Fleafa/VoronUsers/printer_mods/MCMBen/Voron0_Block_and_Tackle_Z_Belt/README.md

# Overview
A block & tackle Z belt implementation for the Voron 0 / 0.1 / 0.2.

The goal was to make use of the original V0 Z motor and timing belt in a compact format, using hardware and screws already in the BoM where possible. No additional M3 nuts need to be preloaded - so no disassembly of the frame.

By default this mod uses 40T & 16T pulleys, combining with the 2:1 of the block and tackle, to give a 5:1 ratio.

Larger pulleys - up to 64 teeth - can be used to increase this ratio, but will require longer timing belts.

## Version 2
I've made some changes in the ~2 years since I first designed this. The affected parts are:
* bed_rear_v3 - reworked to be stronger and print better. Added a heatset insert as I found the plastic self-tapped hole wore out.
* top_bracket_v4 - 'wings' added to add strength and prevent it slipping down under belt tension. Two 6mm screws aid alignment with the vertical extrusions, and two screws utilise the tapped ends of these extrusions to further prevent movement. The clamp (top_bracket_clamp_v1) is now printed separately, for a cleaner look.
* z_tensioner_v2 - minor changes to facilitate the above.
* bottom_bracket_v4 - reworked so that the motor doesn't prevent full belt replacement. The belt is secured from above, making assembly easier. The clamp (bottom_bracket_clamp_v1)  is now printed separately.
The Kirigami bed is now supported. I've based my parts on [LDO's version](https://github.com/MotorDynamicsLab/LDOVoron0/tree/main/STLs/Kirigami), adding an asymmetric stealth bed front design to complement [Christoph Mueller's nut block design](https://github.com/christophmuellerorg/voron_0_kirigami_bed) and a second WAGO mount complementing LDO's breakout mount.

## V0
The standard skirt/feet are too short to accomodate the motor. As such, this mod requires a taller skirt, such as:
* [hartk1213's extrusion skirt mod](https://github.com/VoronDesign/VoronUsers/tree/master/printer_mods/hartk1213/Voron0_ExtrusionSkirt)
* [doubletrouble023's skirt mod](https://github.com/VoronDesign/VoronUsers/tree/master/printer_mods/doubletrouble/V0_Skirt_Mod)
* [my own Trident-style skirt mod](https://github.com/Fleafa/VoronUsers/tree/V0.1-Trident-skirt/printer_mods/MCMBen/Voron0_Block_and_Tackle_Z_Belt)
* [the official V0.2 skirt, based on my design above, but developed further. Nicer to work with!](https://github.com/VoronDesign/Voron-0)

## V0.1
The standard skirt/feet have enough height, though a 64T pulley may be a squeeze.

## V0.2
I haven't removed the Z-stop switch part of the design, so can go sensorless or keep a switch.
The standard Trident-style skirt provides enough space.

*Full Z-travel should be possible, but be sure to check this.*

Both the V0 and V0.1/V0.2 bed positions are supported - just print the appropriate bed_front_\*.stl file.

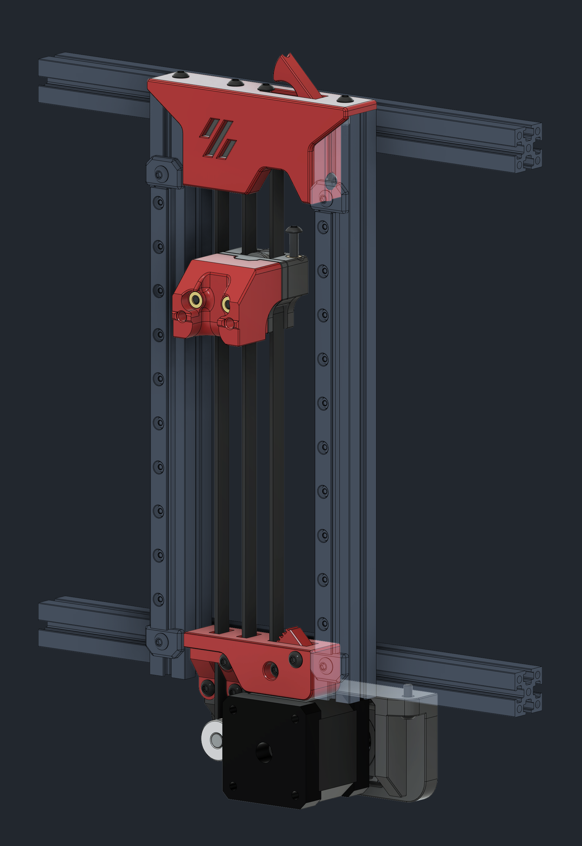
[picture p1: printer_mods/MCMBen/Voron0_Block_and_Tackle_Z_Belt/Images/Block_and_Tackle_Z_Belt_Render_v2.png]

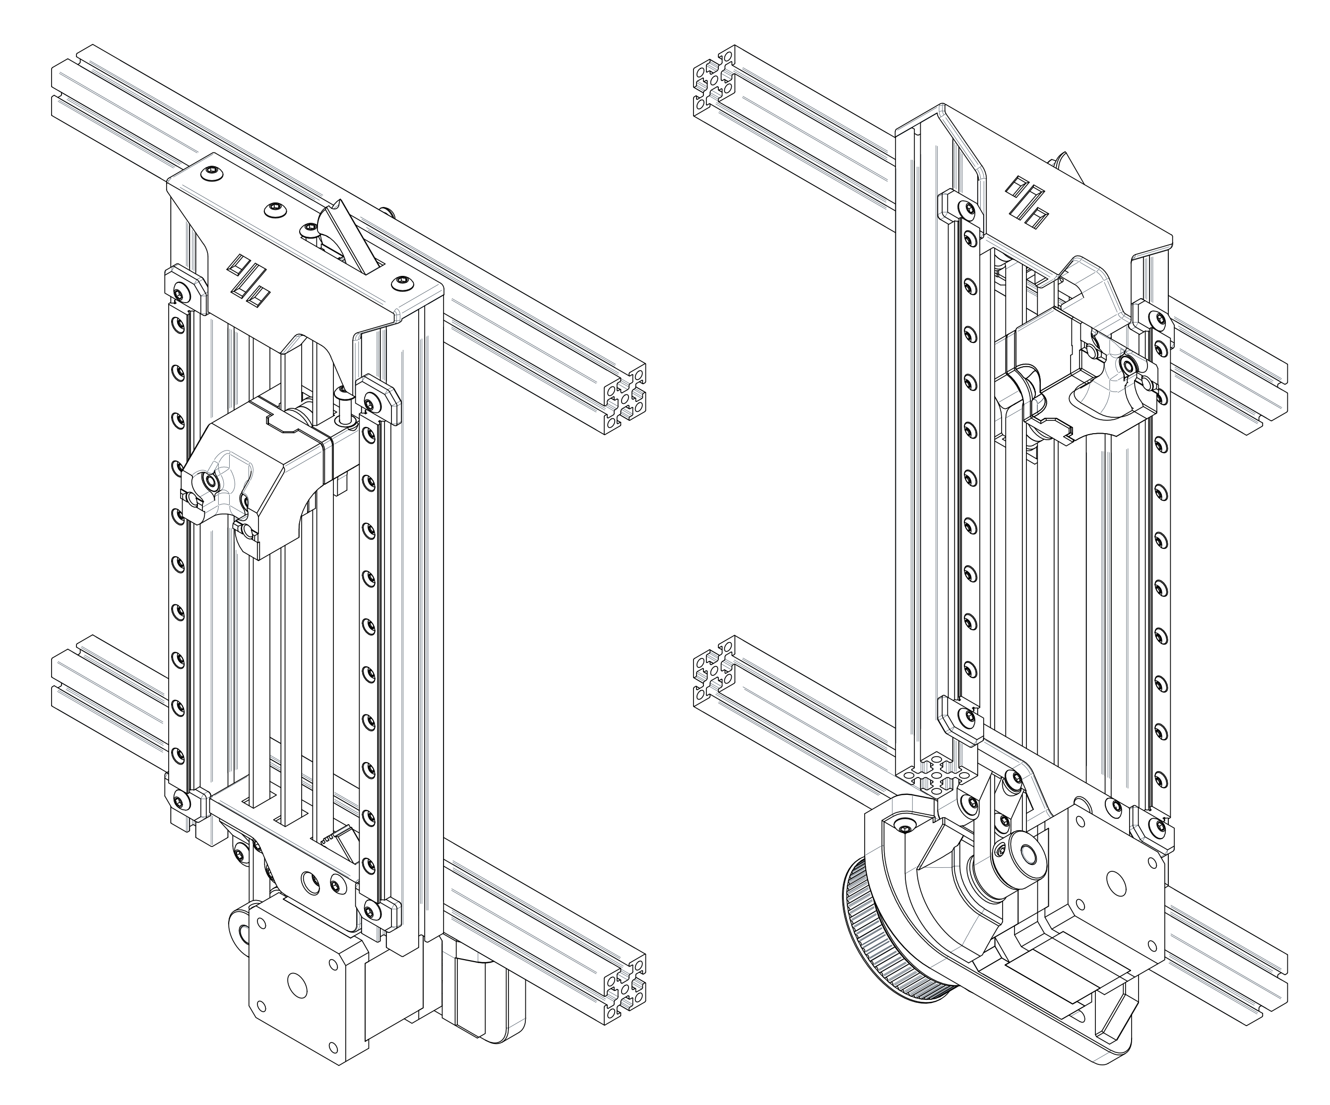
[picture p2: printer_mods/MCMBen/Voron0_Block_and_Tackle_Z_Belt/Images/Block_and_Tackle_Z_Belt_Drawing_v2.png]

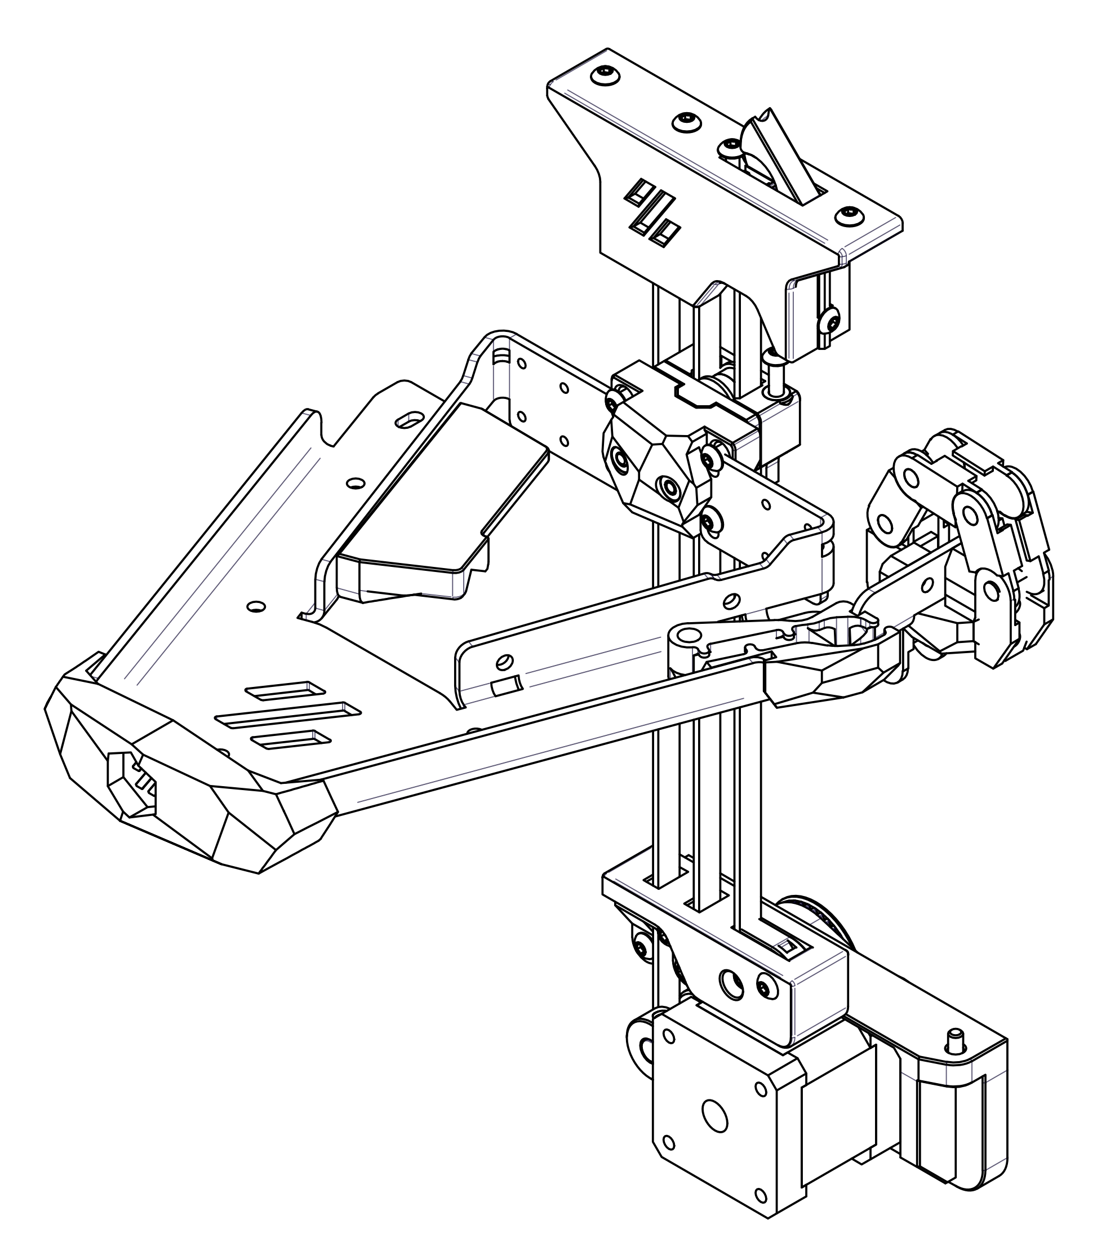
[picture p3: printer_mods/MCMBen/Voron0_Block_and_Tackle_Z_Belt/Images/Block_and_Tackle_Z_Belt_Kirigami.png]


# BoM
This BoM doesn't include Omron switch for the Z stop, though much of the hardware is reused from the V0/V0.1/V0.2 builds.
## Common
Component | Quantity
--- | :-:
M3x6 BHCS | 2
M3x8 BHCS | 1
M3x10 BHCS | 4
M3x12 BHCS | 3
M3x16 BHCS | 4
M3x25 BHCS | 3
M3x30 BHCS | 2
M3 threaded insert | 8
3x12 pin | 3
3x14 pin | 2
F623 bearing | 6
F695 2RS bearing | 1
MF105 bearing | 2
GT2 16T pulley | 3
NEMA14 motor | 1
3x6x0.5 shim | 0
5x10x0.5 shim | 2
5x50 shaft | 1
GATES GT2 open belt | ~700mm
M3 washer | 4
M2x10 self-tapping screw | 2

## Timing Belt
Ratio | Type | Length
--- | :-: | ---
5:1 | GATES GT2 | 110mm
6:1 | GATES GT2 | 122mm
8:1 | GATES GT2 | 152mm
&nbsp; | **OR** | &nbsp;
8:1 | GT2 | 146mm

#Klipper Config
This assumes SKR Mini E3 v2 and stock V0 Z motor.
```
[stepper_z]
step_pin: PB0
dir_pin: !PC5           # Remove ! if moving opposite direction
enable_pin: !PB1
rotation_distance: 32
gear_ratio: 40:16, 2:1
full_steps_per_rotation: 200
microsteps: 16
endstop_pin: PC2
position_endstop: -0.10
position_max: 120       # Check that there is enough travel
position_min: -1.5
homing_speed: 20        # Default 20, Max 100
second_homing_speed: 3.0
homing_retract_dist: 3.0

[tmc2209 stepper_z]
uart_pin: PC11
tx_pin: PC10
uart_address: 1
interpolate: True
run_current: 0.37       # For V0 spec NEMA17 LDO-35STH42-0504AH
hold_current: 0.35
sense_resistor: 0.110
stealthchop_threshold: 500

[printer]
max_z_velocity: 30      # Default 15, test before increasing
max_z_accel: 350        # Default 45, test before increasing
```
