Fleafa/VoronUsers/printer_mods/MCMBen/Voron0_Block_and_Tackle_Z_Belt/STLs/bed_front_kirigami_v1.stl

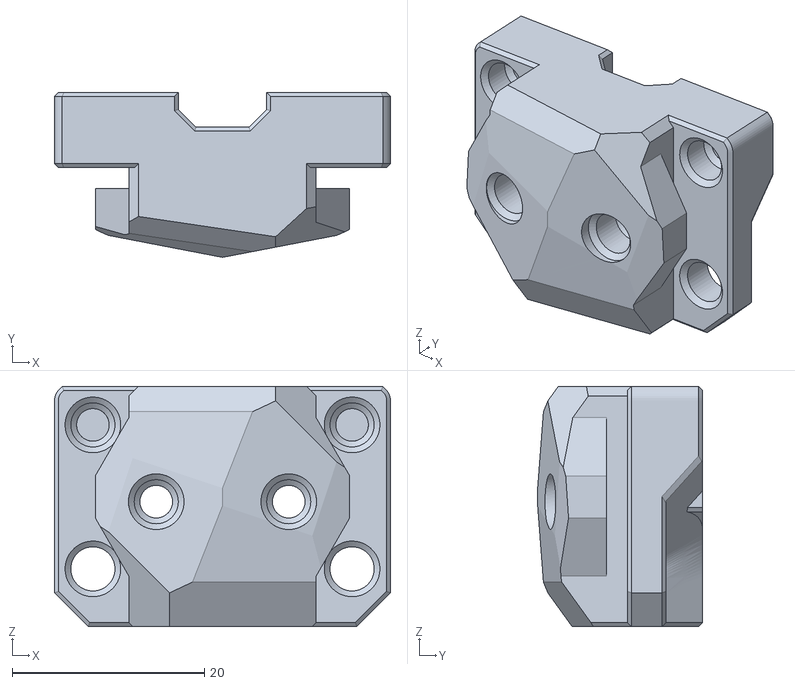
[picture p4: CAD file, 2023-05-16]
printer_mods/MCMBen/Voron0_Block_and_Tackle_Z_Belt/STLs/bed_front_kirigami_v1.stl
35.0 x 17.2 x 25.0
