Fleafa/VoronUsers/printer_mods/MCMBen/Voron0_Trident_Skirt/CAD/V0.1_Trident_Skirt_NoDisplay.step

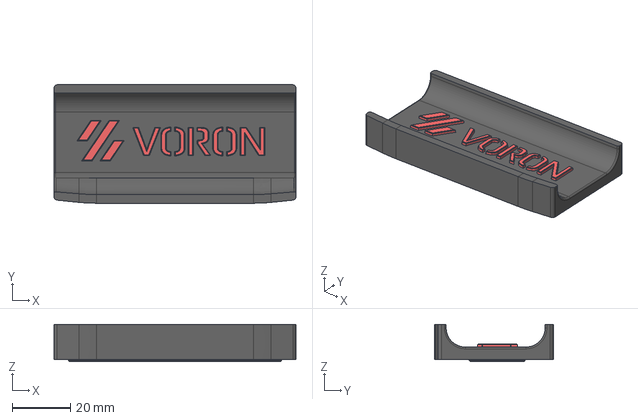
[picture p5: CAD file, 2021-11-09]
printer_mods/MCMBen/Voron0_Trident_Skirt/CAD/V0.1_Trident_Skirt_NoDisplay.step
83.2 x 40.7 x 12.8 mm
skirt_front_through_logo
[a]_skirt_front_through_logo_insert
