Fleafa/VoronUsers/printer_mods/MCMBen/Voron0_Trident_Skirt/STLs/[a]_skirt_front_through_logo_insert.stl

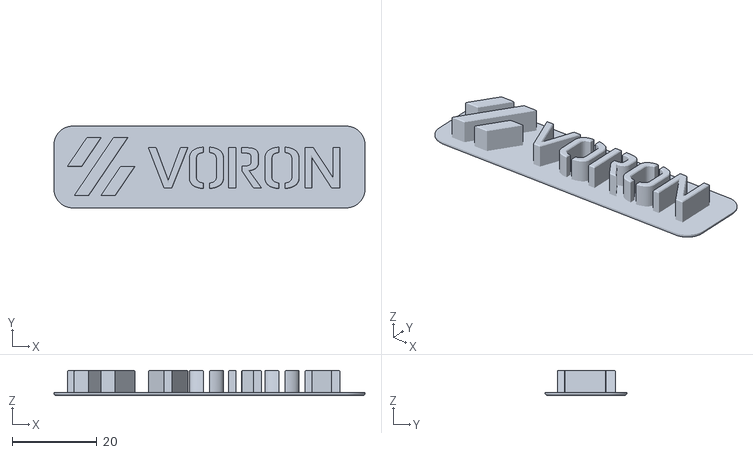
[picture p6: CAD file, 2021-10-23]
printer_mods/MCMBen/Voron0_Trident_Skirt/STLs/[a]_skirt_front_through_logo_insert.stl
73.3 x 19.3 x 6.00
