Fleafa/VoronUsers/printer_mods/MCMBen/Voron0_Block_and_Tackle_Z_Belt/STLs/kirigami-wago.stl

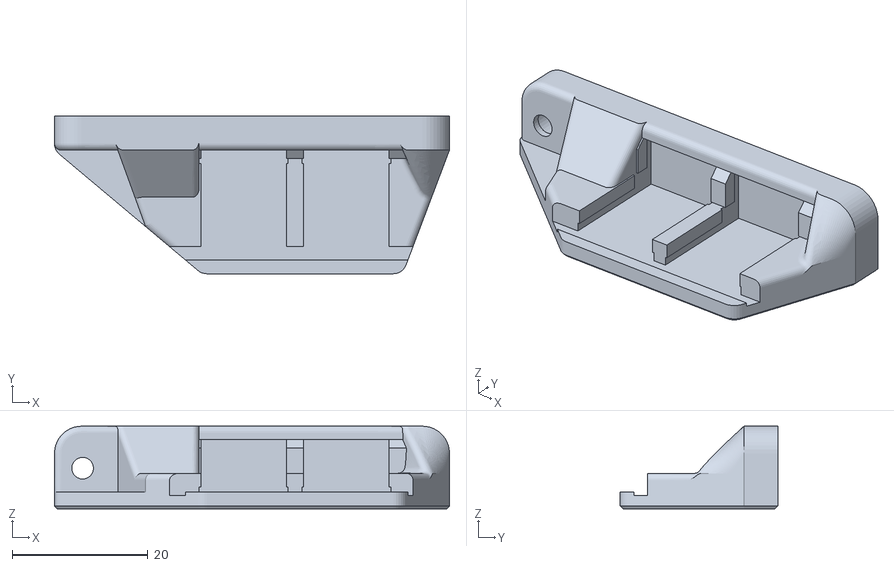
[picture p7: CAD file, 2023-05-16]
printer_mods/MCMBen/Voron0_Block_and_Tackle_Z_Belt/STLs/kirigami-wago.stl
58.3 x 23.3 x 12.2
