Fleafa/VoronUsers/printer_mods/MCMBen/Voron0_Trident_Skirt/STLs/skirt_front_through_logo.stl

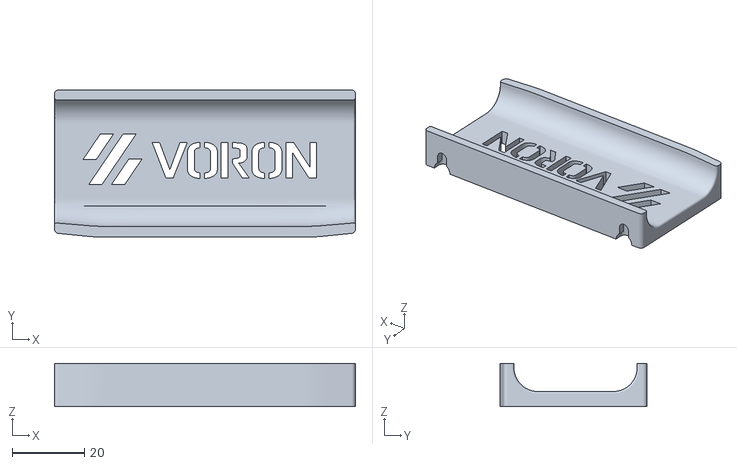
[picture p8: CAD file, 2021-10-23]
printer_mods/MCMBen/Voron0_Trident_Skirt/STLs/skirt_front_through_logo.stl
83.2 x 40.7 x 12.0
