Fleafa/VoronUsers/printer_mods/MCMBen/Voron0_Block_and_Tackle_Z_Belt/STLs/kirigami_stealth_ldo_v1.stl

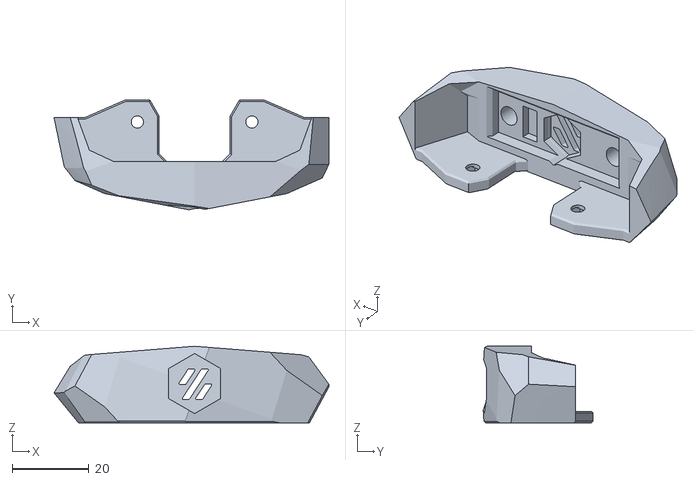
[picture p9: CAD file, 2023-05-16]
printer_mods/MCMBen/Voron0_Block_and_Tackle_Z_Belt/STLs/kirigami_stealth_ldo_v1.stl
71.9 x 28.7 x 20.0
