Fleafa/VoronUsers/printer_mods/MCMBen/Voron0_Block_and_Tackle_Z_Belt/STLs/bottom_bracket_clamp_v2.stl

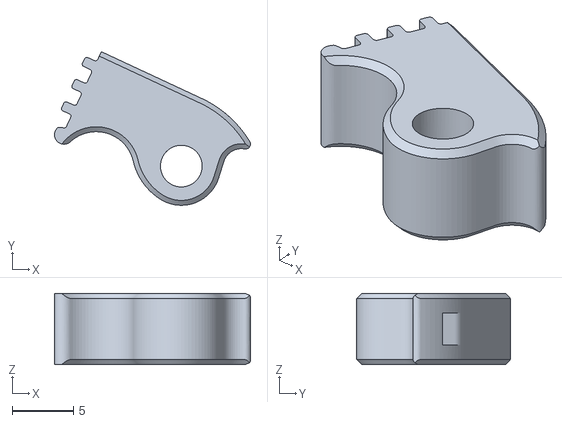
[picture p11: CAD file, 2023-05-16]
printer_mods/MCMBen/Voron0_Block_and_Tackle_Z_Belt/STLs/bottom_bracket_clamp_v2.stl
16.0 x 12.5 x 5.80
