Fleafa/VoronUsers/printer_mods/MCMBen/Voron0_Trident_Skirt/STLs/corner_rear_left_C14_BoM.stl

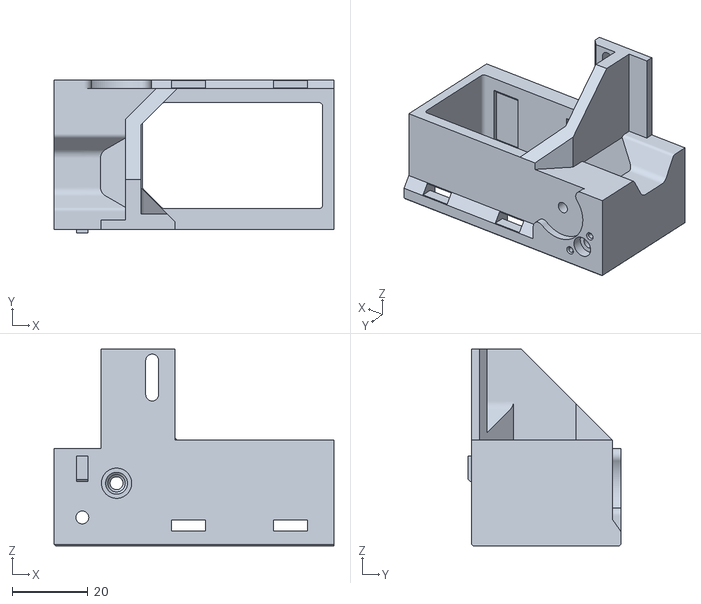
[picture p12: CAD file, 2021-10-15]
printer_mods/MCMBen/Voron0_Trident_Skirt/STLs/corner_rear_left_C14_BoM.stl
74.1 x 40.5 x 52.0
