Fleafa/VoronUsers/printer_mods/MCMBen/Voron0_Block_and_Tackle_Z_Belt/STLs/bed_front_Voron0.1_0.2_v1.stl

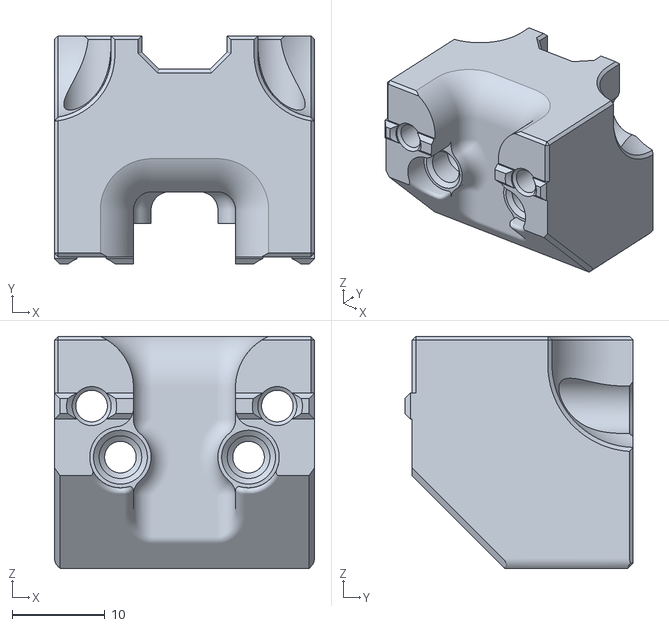
[picture p13: CAD file, 2023-05-03]
printer_mods/MCMBen/Voron0_Block_and_Tackle_Z_Belt/STLs/bed_front_Voron0.1_0.2_v1.stl
28.0 x 24.6 x 25.0
