Fleafa/VoronUsers/printer_mods/MCMBen/Voron0_Block_and_Tackle_Z_Belt/STLs/top_bracket_clamp_v1.stl

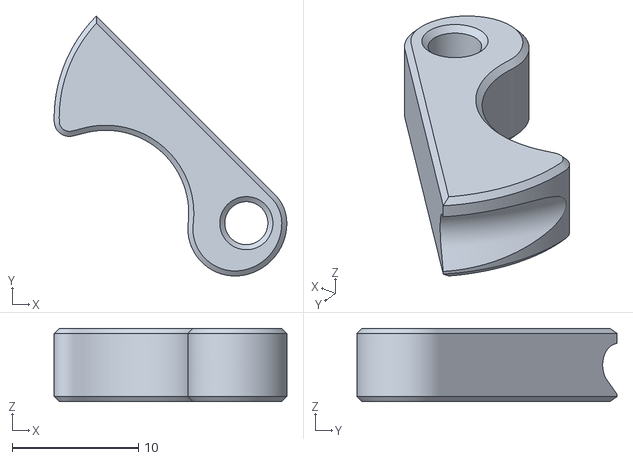
[picture p14: CAD file, 2023-05-03]
printer_mods/MCMBen/Voron0_Block_and_Tackle_Z_Belt/STLs/top_bracket_clamp_v1.stl
18.4 x 20.6 x 5.80
