Fleafa/VoronUsers/printer_mods/MCMBen/Voron0_Trident_Skirt/STLs/[a]_screen_insert.stl

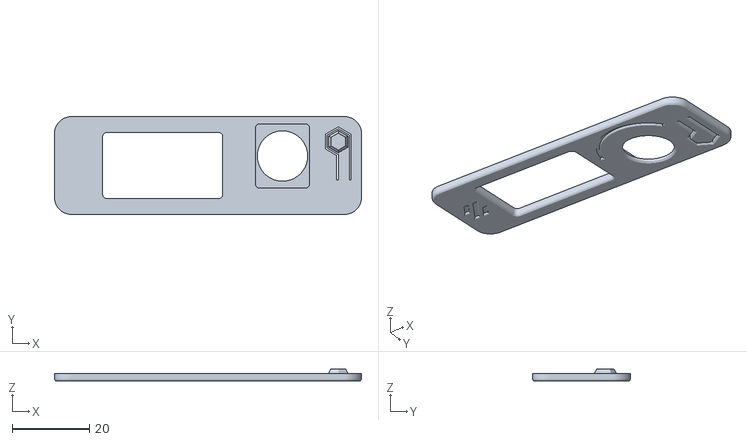
[picture p15: CAD file, 2021-10-15]
printer_mods/MCMBen/Voron0_Trident_Skirt/STLs/[a]_screen_insert.stl
79.3 x 25.3 x 3.20
