Fleafa/VoronUsers/printer_mods/MCMBen/Voron0_Block_and_Tackle_Z_Belt/STLs/top_bracket_v4.stl

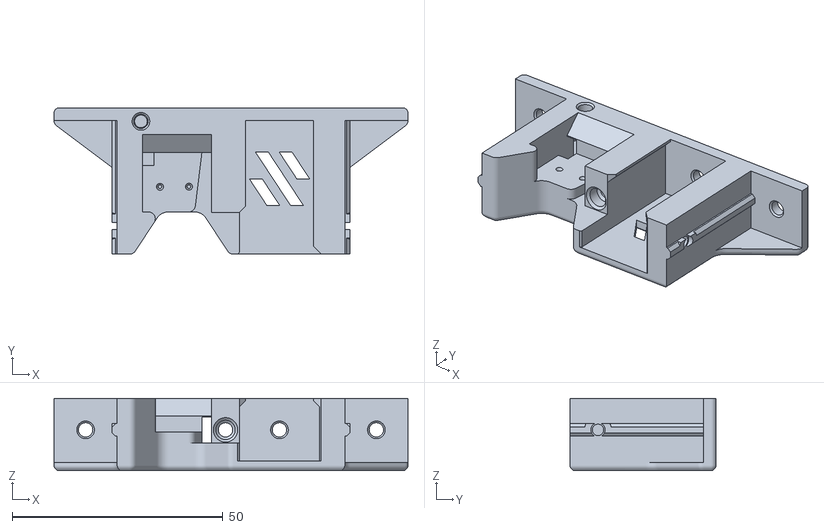
[picture p16: CAD file, 2023-05-03]
printer_mods/MCMBen/Voron0_Block_and_Tackle_Z_Belt/STLs/top_bracket_v4.stl
84.0 x 34.7 x 17.2
