Fleafa/VoronUsers/printer_mods/MCMBen/Voron0_Trident_Skirt/STLs/encoder_knob.stl

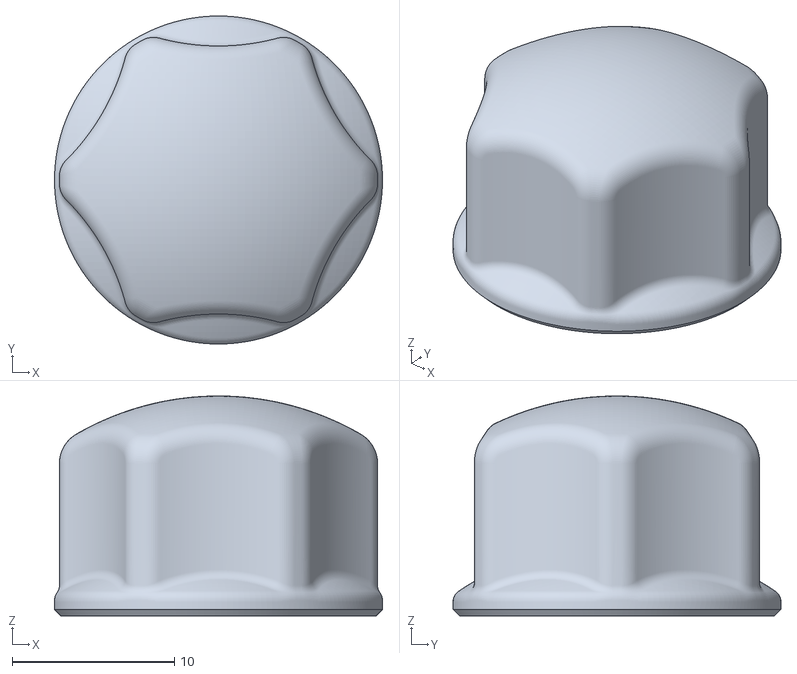
[picture p17: CAD file, 2021-10-15]
printer_mods/MCMBen/Voron0_Trident_Skirt/STLs/encoder_knob.stl
20.2 x 20.2 x 13.5
