Fleafa/VoronUsers/printer_mods/MCMBen/Voron0_Block_and_Tackle_Z_Belt/STLs/[a]_z_tensioner_v2.stl

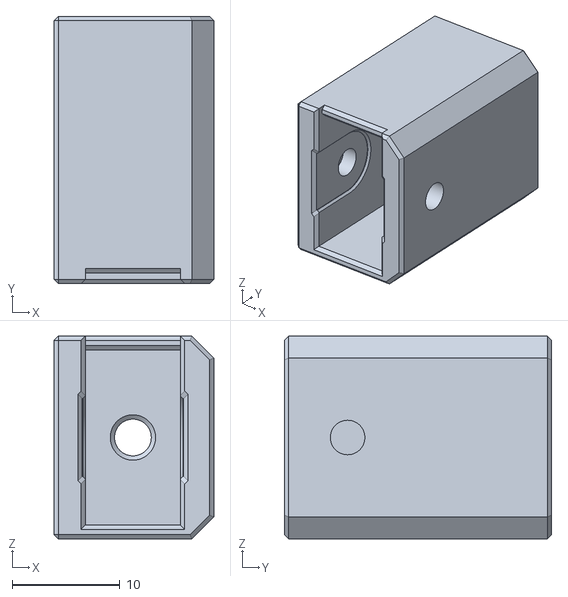
[picture p18: CAD file, 2023-05-03]
printer_mods/MCMBen/Voron0_Block_and_Tackle_Z_Belt/STLs/[a]_z_tensioner_v2.stl
14.8 x 24.7 x 18.8
