Fleafa/VoronUsers/printer_mods/MCMBen/Voron0_Trident_Skirt/STLs/display_front.stl

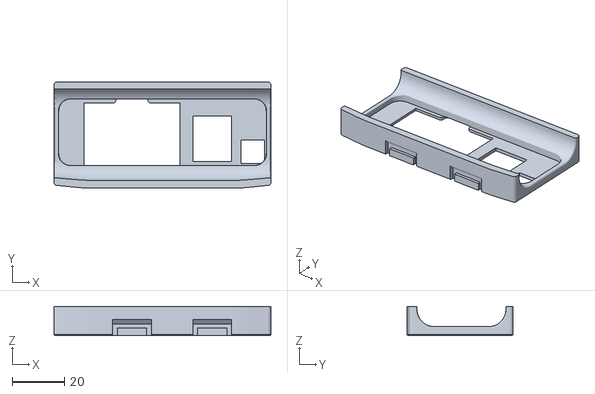
[picture p19: CAD file, 2021-10-15]
printer_mods/MCMBen/Voron0_Trident_Skirt/STLs/display_front.stl
83.2 x 40.7 x 11.3
