Fleafa/VoronUsers/printer_mods/MCMBen/Voron0_Block_and_Tackle_Z_Belt/STLs/bottom_bracket_v4.stl

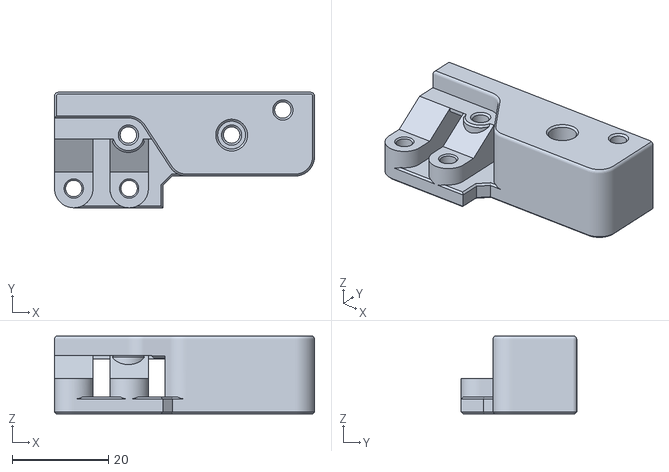
[picture p20: CAD file, 2023-05-03]
printer_mods/MCMBen/Voron0_Block_and_Tackle_Z_Belt/STLs/bottom_bracket_v4.stl
54.0 x 24.0 x 16.2
