Fleafa/VoronUsers/printer_mods/MCMBen/Voron0_Trident_Skirt/STLs/display_middle.stl

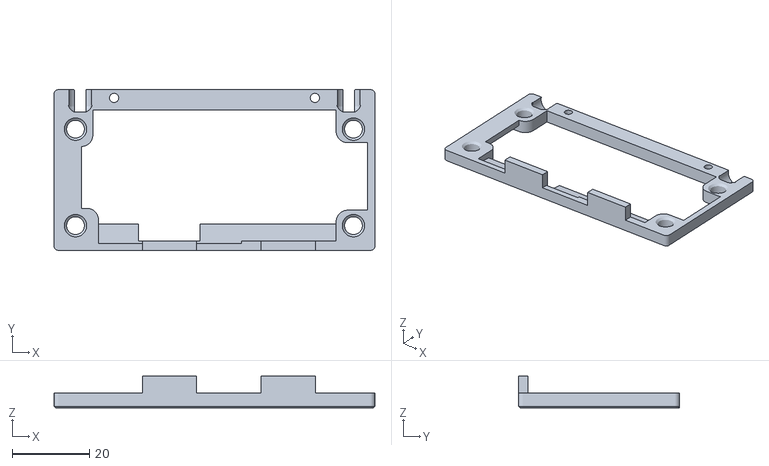
[picture p21: CAD file, 2021-10-15]
printer_mods/MCMBen/Voron0_Trident_Skirt/STLs/display_middle.stl
83.2 x 41.7 x 8.20
