Fleafa/VoronUsers/printer_mods/MCMBen/Voron0_Block_and_Tackle_Z_Belt/STLs/bed_rear_v3.stl

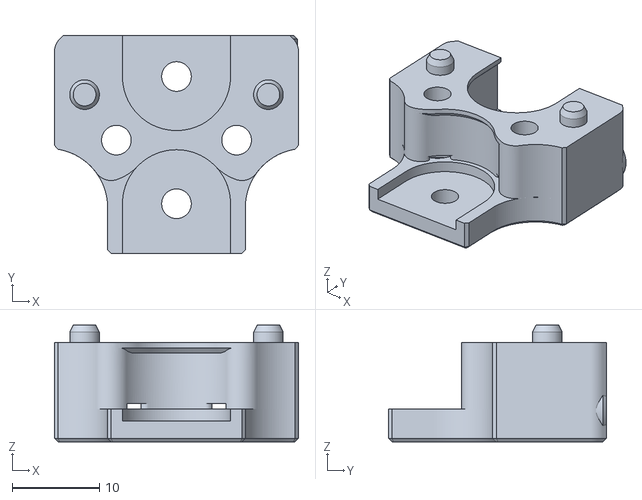
[picture p22: CAD file, 2023-05-03]
printer_mods/MCMBen/Voron0_Block_and_Tackle_Z_Belt/STLs/bed_rear_v3.stl
28.0 x 25.0 x 13.4
