Fleafa/VoronUsers/printer_mods/MCMBen/Voron0_Trident_Skirt/STLs/[a]_fan_blank_40mm_x2.stl

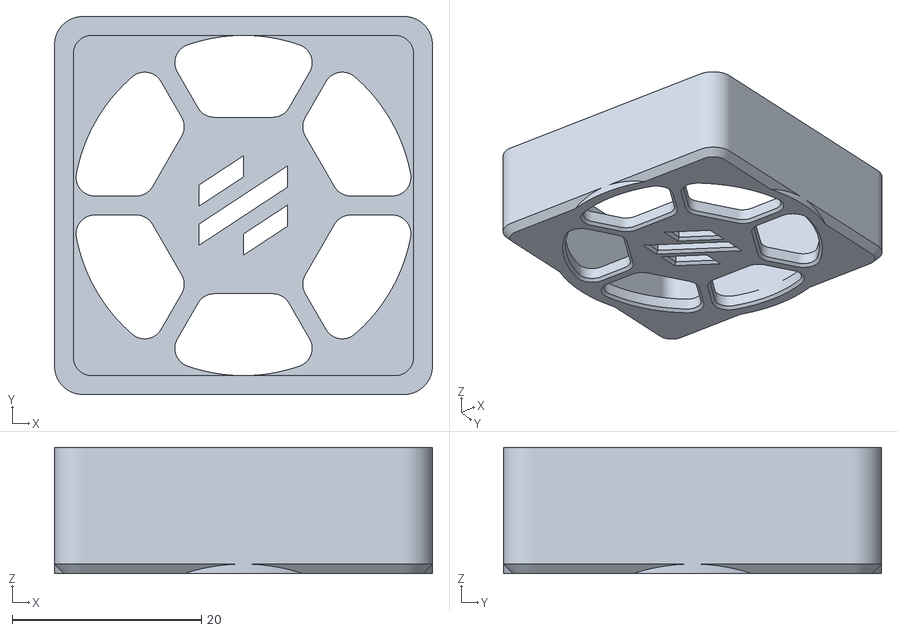
[picture p24: CAD file, 2021-10-07]
printer_mods/MCMBen/Voron0_Trident_Skirt/STLs/[a]_fan_blank_40mm_x2.stl
40.0 x 40.0 x 13.3
