Fleafa/VoronUsers/printer_mods/MCMBen/Voron0_Trident_Skirt/STLs/[a]_skirt_logo_x2.stl

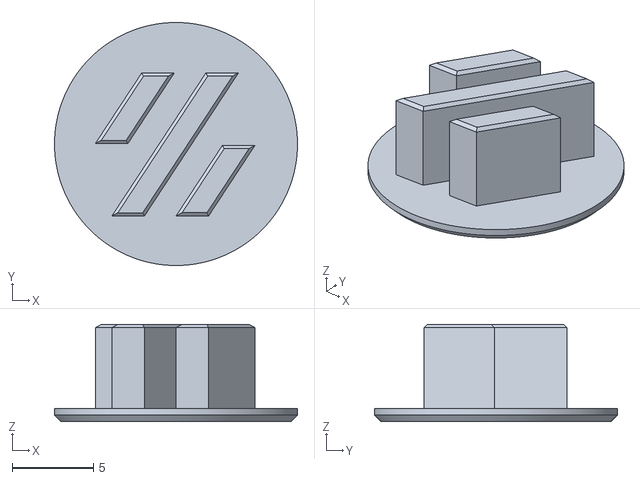
[picture p25: CAD file, 2021-10-07]
printer_mods/MCMBen/Voron0_Trident_Skirt/STLs/[a]_skirt_logo_x2.stl
15.0 x 15.0 x 6.00
