Fleafa/VoronUsers/printer_mods/MCMBen/Voron0_Trident_Skirt/STLs/corner_front_left.stl

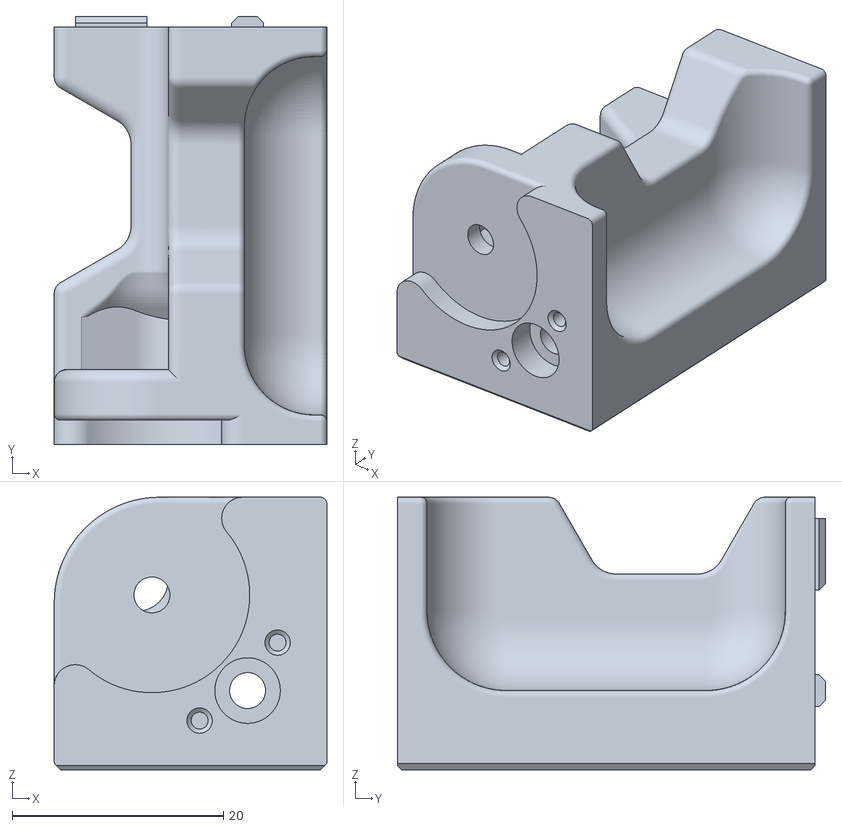
[picture p26: CAD file, 2021-10-07]
printer_mods/MCMBen/Voron0_Trident_Skirt/STLs/corner_front_left.stl
25.8 x 40.5 x 25.8
