Fleafa/VoronUsers/printer_mods/MCMBen/Voron0_Trident_Skirt/STLs/skirt_side_B_x2.stl

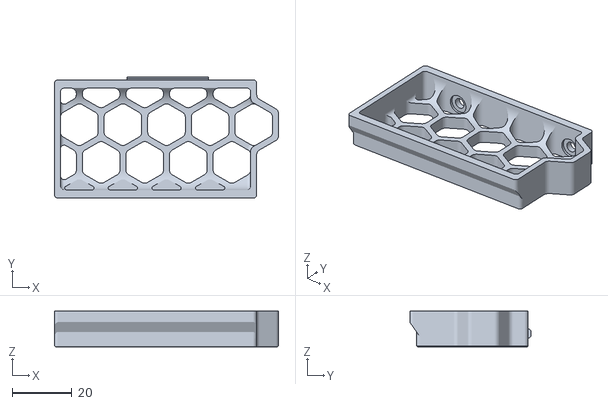
[picture p27: CAD file, 2021-10-07]
printer_mods/MCMBen/Voron0_Trident_Skirt/STLs/skirt_side_B_x2.stl
74.7 x 40.5 x 12.0
