Fleafa/VoronUsers/printer_mods/MCMBen/Voron0_Trident_Skirt/STLs/skirt_front_right.stl

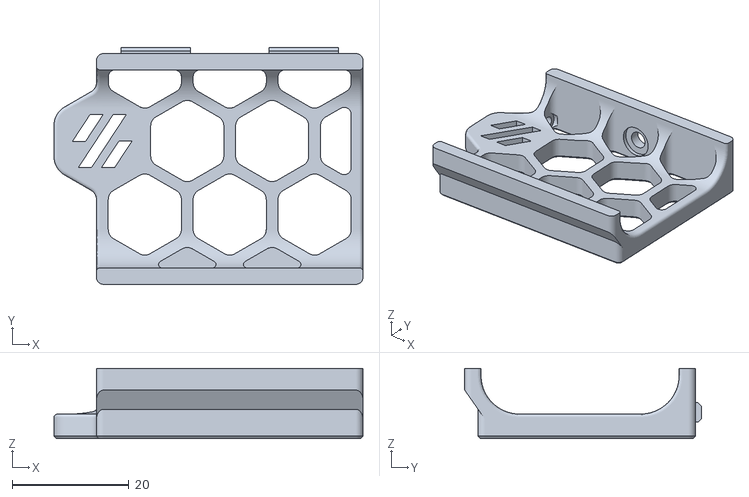
[picture p28: CAD file, 2021-10-07]
printer_mods/MCMBen/Voron0_Trident_Skirt/STLs/skirt_front_right.stl
52.9 x 40.5 x 12.0
