Fleafa/VoronUsers/printer_mods/MCMBen/Voron0_Trident_Skirt/STLs/[a]_corner_baseplate_x4.stl

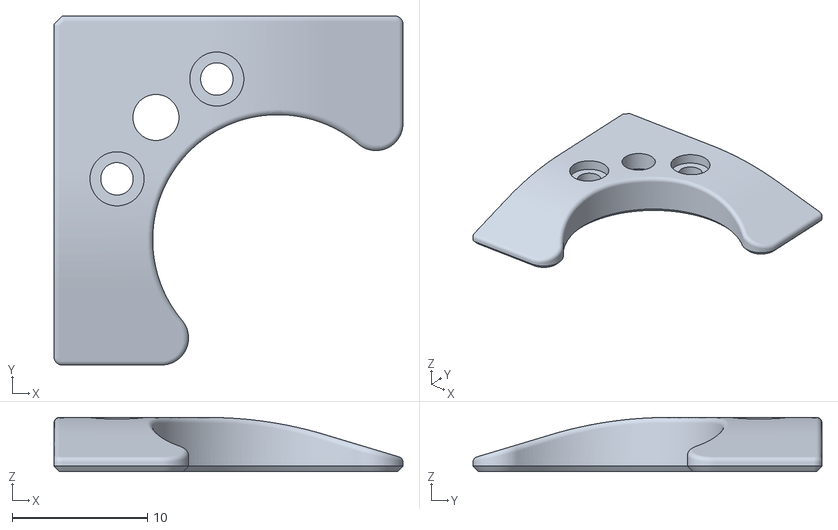
[picture p29: CAD file, 2021-10-07]
printer_mods/MCMBen/Voron0_Trident_Skirt/STLs/[a]_corner_baseplate_x4.stl
25.8 x 25.8 x 4.00
