Fleafa/VoronUsers/(list of files, cad)

Other CAD files:
printer_mods/MCMBen/Voron0_Trident_Skirt/STLs/corner_rear_right_C14_BoM.stl
printer_mods/MCMBen/Voron0_Trident_Skirt/STLs/corner_rear_right_C14_RS.stl
printer_mods/MCMBen/Voron0_Trident_Skirt/STLs/skirt_side_A_x2.stl
printer_mods/MCMBen/Voron0_Trident_Skirt/STLs/corner_front_right.stl
printer_mods/MCMBen/Voron0_Trident_Skirt/STLs/skirt_front_left.stl
printer_mods/MCMBen/Voron0_Trident_Skirt/CAD/V0.1_Trident_Skirt_NoDisplay.f3d
