Fleafa/VoronUsers/printer_mods/MCMBen/Voron0_Trident_Skirt/Images/Assembly-01.png

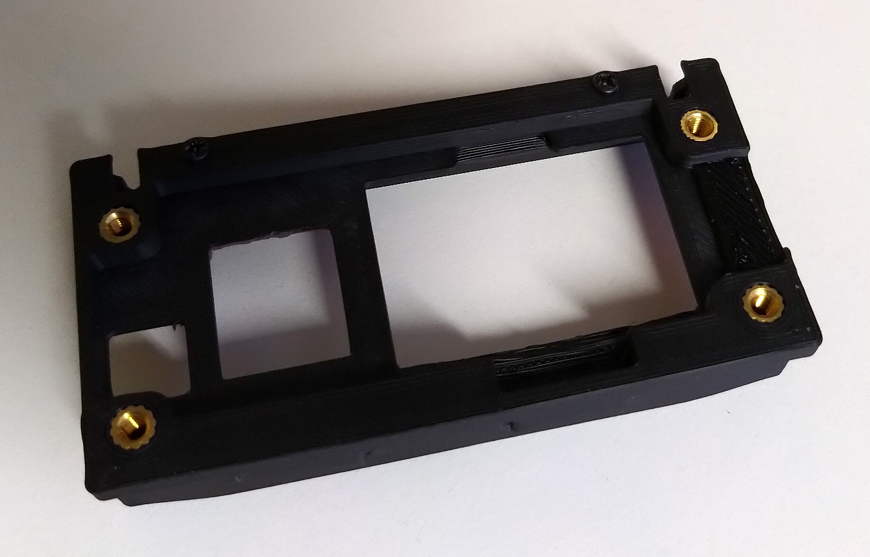
printer_mods/MCMBen/Voron0_Trident_Skirt/Images/Assembly-01.png
