Fleafa/VoronUsers/(commit log)

2021-10-15 Added display housing
2021-10-15 Added BoM C14
2021-10-15 Added BoM C14 and fixed orientation
    [[a]_screen_insert.stl, corner_rear_right_C14_BoM.stl, encoder_knob.stl]
2021-10-15 Added mirrored C14 options
    [corner_rear_left_C14_BoM.stl, corner_rear_left_C14_RS.stl]
2021-10-23 Added front section for those without a display
    [[a]_skirt_front_through_logo_insert.stl, skirt_front_through_logo.stl]
2021-11-09 Added CAD for no display front section.
    [V0.1_Trident_Skirt_NoDisplay.f3d, V0.1_Trident_Skirt_NoDisplay.step]
2023-05-03 latest version
    [[a]_z_tensioner_v2.stl, bed_rear_v3.stl, bottom_bracket_clamp_v1.stl, bottom_bracket_v4.stl, top_bracket_clamp_v1.stl, top_bracket_v4.stl]
2023-05-03 V0.2 support explicit
    [bed_front_Voron0.1_0.2_v1.stl]
2023-05-15 tweaked tolerances
    [bottom_bracket_clamp_v2.stl]
2023-05-16 added kirigami compatability
    [bed_front_kirigami_v1.stl, kirigami-wago.stl, kirigami_stealth_ldo_v1.stl]
